vadzimyatskevich/uv_timer/doc/img/IMG_6582.JPG

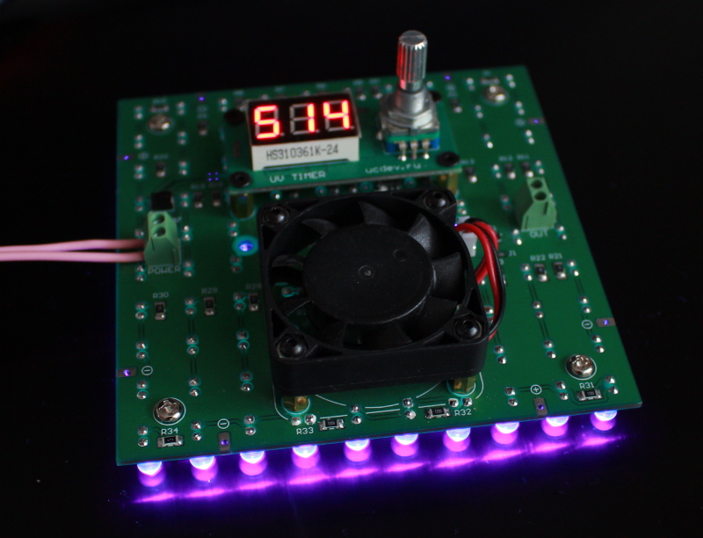
doc/img/IMG_6582.JPG
