vadzimyatskevich/uv_timer/doc/img/uv8.jpg

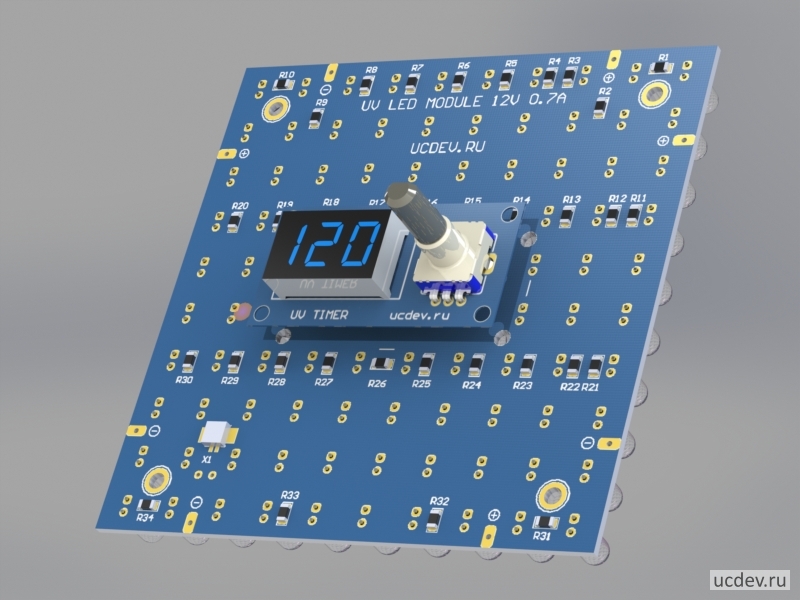
doc/img/uv8.jpg
