vadzimyatskevich/uv_timer/doc/img/W1209_ca_cc.jpg

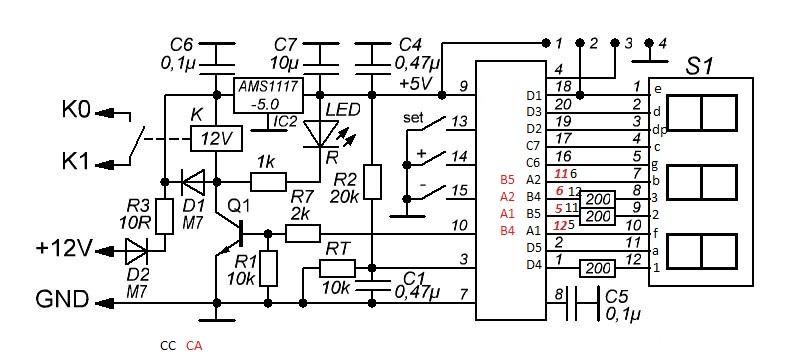
doc/img/W1209_ca_cc.jpg
