vadzimyatskevich/uv_timer/pcb/UVTimerBOM.ods

ec11ec | value | Quantity | Comment
B1 | EC11E vertical with push-on switch | 1 | EC11E
C1, C2 | 8pF | 2 | CERAMIC 0603
C3, C4, C7 | 0.1uF | 3 | CERAMIC 0603
C5, C6 | 1uF | 2 | CERAMIC 0603
C8, C9, C10 | 10nF | 3 | CERAMIC 0603
DA1 |  | 1 | L78L33/L78L50 SOT89
DD1 | STM8S103F3P6 | 1 | STM8S103F3PX
HL1 | 0.36" 3dig CA | 1 | 0.36” 3-digit, comm anode
J1 | instead of fuse | 1 | JUMP-2
J2 | programming | 1
R1, R4, R7, R8 | 10k | 4 | RES0603
R2 | 100k | 1 | RES0603
R3 | MF-MSMF110/16 | 1 | 1812 PPTC
R5, R6 | 330 | 2 | RES0603x4
R9 | 10k | 1 | RES0603x4
VT1 | AO3400A | 1 | AO3400A
XP1 |  | 1 | MOLEX 53398-0471
XP2 |  | 1 | PLL1.27-4
ZQ1 | 8MHz | 1 | 5032 8MHz
