vadzimyatskevich/uv_timer/(commit log)

2017-07-06 schematic and renders
2018-04-10 update
    added W1209 board support , encoder sensitity enhancement
2019-05-12 added pcb
    [UVTimerBOM.ods]
